DG-7D/YuinoCraneGame/SerialParallelPWM/README.md

# PWM出力シリアルパラレル変換器

UARTで受信したビット列の各ビットに対応するピンから予め設定されたデューティー比のPWM信号を出力します。通常のシリアルパラレル変換器と異なりクロックが不要かつPWM出力ができます。

## ピン配置

### シリアル端子 (左上)

左から
- RESET
- TX
- RX

### パラレル出力端子 (中央上)

左から0-7

### 5V入力端子 (右上)

左から
- 5V
- GND

### 電源入力端子 (左下)

左から
- GND
- VCC

## 使い方

1バイト(8bit)のデータを受信すると、それぞれのビットが出力に対応します。
