DG-7D/YuinoCraneGame/LV8548MC/README.md

# LV8548MC

LV8548MCを2つまとめただけの基板です。

## ピン配置

### 入力端子 (右上)

左から0-7

### 出力端子 (右)

下から7-0

### 電源入力端子 (左下)

左から
- GND
- VCC
