DG-7D/YuinoCraneGame/クレーンゲーム操作方法.pdf

# クレーンゲーム操作方法

部員へ
- ACアダプタをコンセントに接続すると自動で初期化され、ボタンが光ると準備OKです
- 不具合が起きたらACアダプタををさしなおしてみてください
- なくなりそうだったら景品の補充をお願いします
- ボタンが光っているとき操作できます
- スティックを動かすとプレイ開始できます
- ボタンをおすか、一定時間がたつとアームがつかみます
- カプセルは袋へ返却してください
- 景品はご自由にお持ち帰りください
