DG-7D/YuinoCraneGame/Joystick/PCB/ジョイスティック.kicad_pcb

## KiCad design Joystick/PCB/ジョイスティック.kicad_pcb (2025-11-23)

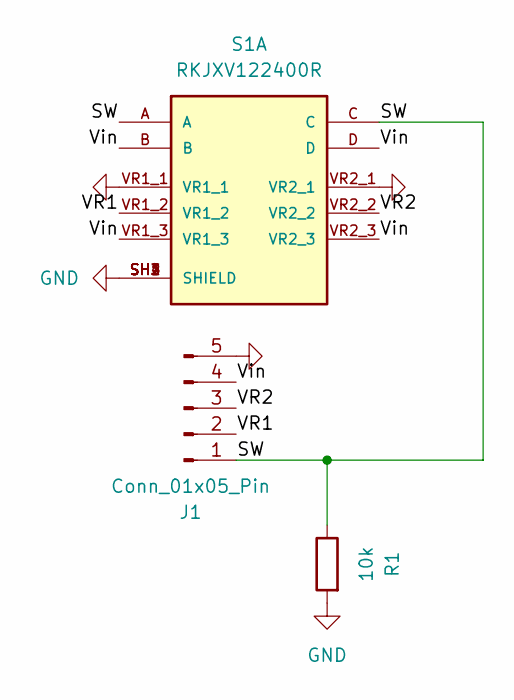
[picture p1: schematic ジョイスティック.kicad_sch]

Parts:
J1: Conn_01x05_Pin; PinHeader_1x05_P2.54mm_Horizontal
R1: 10k; R_0603_1608Metric
S1: RKJXV122400R; SW_RKJXV122400R; PARTREV N/A

Connections:
/SW: J1.1, R1.1, S1.A, S1.C
/VR1: J1.2, S1.VR1_2
/VR2: J1.3, S1.VR2_2
/Vin: J1.4, S1.B, S1.D, S1.VR1_3, S1.VR2_3
GND: J1.5, R1.2, S1.SH1 (SHIELD), S1.SH2 (SHIELD), S1.SH3 (SHIELD), S1.SH4 (SHIELD), S1.VR1_1, S1.VR2_1

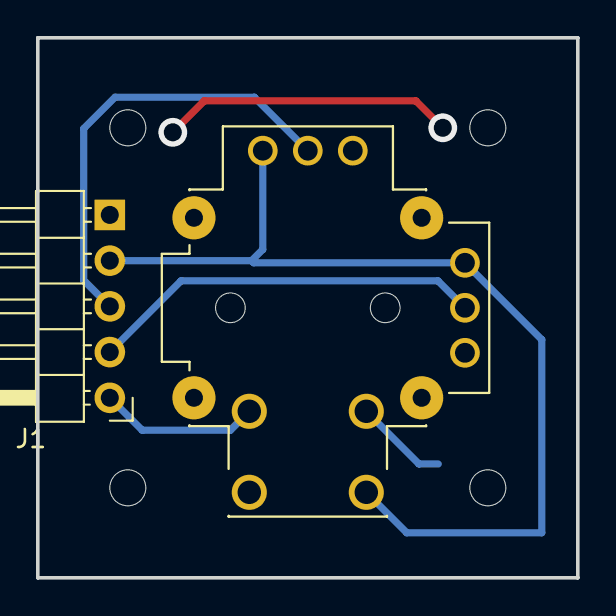
[picture p2: board ジョイスティック.kicad_pcb from above]

Board: 2 copper layers, 30.0 x 30.0 mm, 3 parts (1 on the bottom side), 5 nets.
