DG-7D/YuinoCraneGame/LV8548MC/PCB/LV8548MC.kicad_pcb

## KiCad design LV8548MC/PCB/LV8548MC.kicad_pcb (2025-04-22)

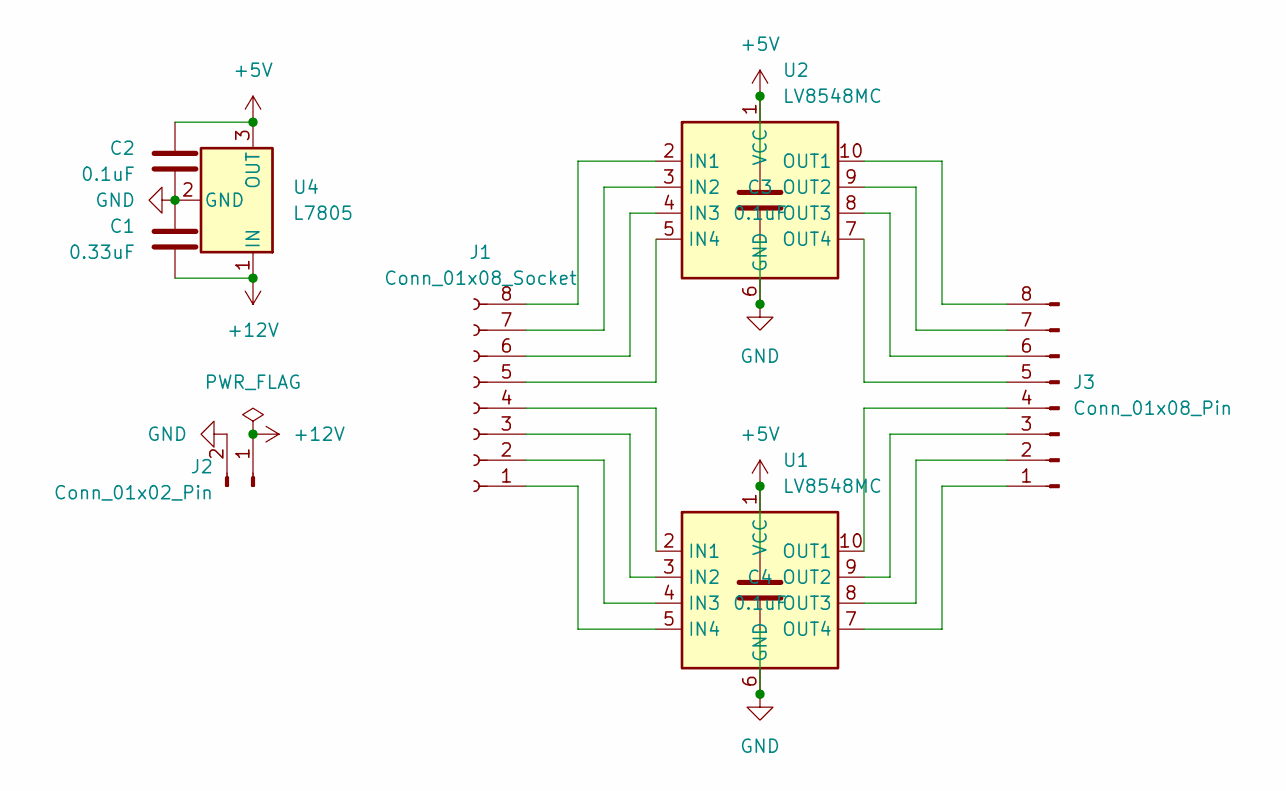
[picture p3: schematic LV8548MC.kicad_sch]

Parts:
C1: 0.33uF; C_0603_1608Metric_Pad1.08x0.95mm_HandSolder
C2, C3, C4: 0.1uF; C_0603_1608Metric_Pad1.08x0.95mm_HandSolder
J1: Conn_01x08_Socket; PinSocket_1x08_P2.54mm_Horizontal
J2: Conn_01x02_Pin; PinHeader_1x02_P2.54mm_Horizontal
J3: Conn_01x08_Pin; PinHeader_1x08_P2.54mm_Horizontal
U1, U2: LV8548MC; SOIC-10_3.9x4.9mm_P1mm
U4: L7805; TO-220-3_Horizontal_TabDown

Connections:
+5V: C2.1, C3.1, C4.1, U1.1 (VCC), U2.1 (VCC), U4.3 (OUT)
+12V: C1.1, J2.1, U4.1 (IN)
GND: C1.2, C2.2, C3.2, C4.2, J2.2, U1.6 (GND), U2.6 (GND), U4.2 (GND)
unnamed: J1.1, U1.5 (IN4)
unnamed: J1.2, U1.4 (IN3)
unnamed: J1.3, U1.3 (IN2)
unnamed: J1.4, U1.2 (IN1)
unnamed: J1.5, U2.5 (IN4)
unnamed: J1.6, U2.4 (IN3)
unnamed: J1.7, U2.3 (IN2)
unnamed: J1.8, U2.2 (IN1)
unnamed: J3.1, U1.7 (OUT4)
unnamed: J3.2, U1.8 (OUT3)
unnamed: J3.3, U1.9 (OUT2)
unnamed: J3.4, U1.10 (OUT1)
unnamed: J3.5, U2.7 (OUT4)
unnamed: J3.6, U2.8 (OUT3)
unnamed: J3.7, U2.9 (OUT2)
unnamed: J3.8, U2.10 (OUT1)

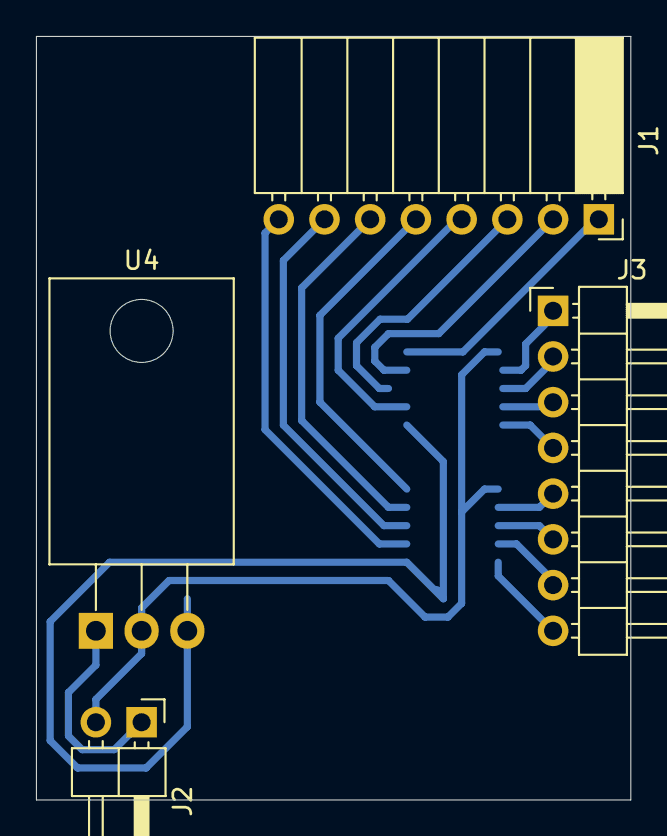
[picture p4: board LV8548MC.kicad_pcb from above]

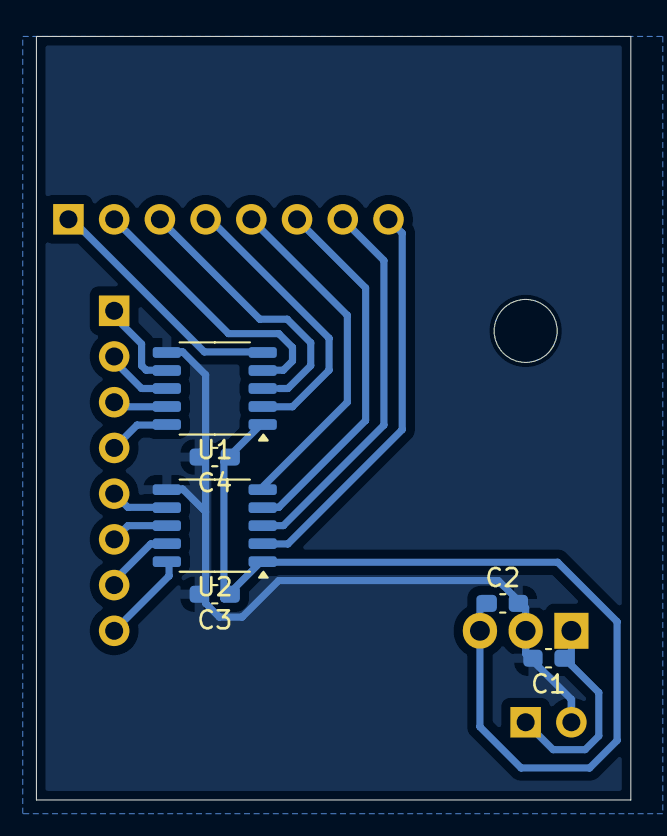
[picture p5: board LV8548MC.kicad_pcb from below]

Board: 2 copper layers, 33.0 x 42.4 mm, 10 parts (6 on the bottom side), 19 nets.
