DG-7D/YuinoCraneGame/SerialParallelPWM/ISCPAdapter/ISCPAdapter.kicad_pcb

## KiCad design SerialParallelPWM/ISCPAdapter/ISCPAdapter.kicad_pcb (2025-04-22)

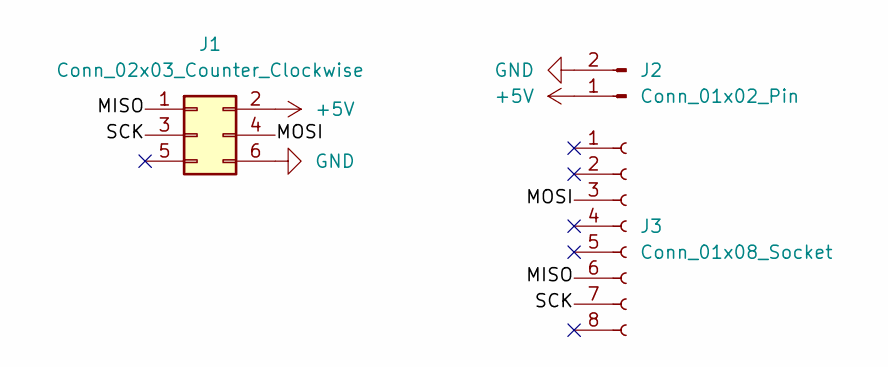
[picture p6: schematic ISCPAdapter.kicad_sch]

Parts:
J1: Conn_02x03_Counter_Clockwise; PinSocket_2x03_P2.54mm_Vertical
J2: Conn_01x02_Pin; PinHeader_1x02_P2.54mm_Horizontal
J3: Conn_01x08_Socket; PinSocket_1x08_P2.54mm_Horizontal

Connections:
+5V: J1.2, J2.1
/MISO: J1.1, J3.6
/MOSI: J1.4, J3.3
/SCK: J1.3, J3.7
GND: J1.6, J2.2

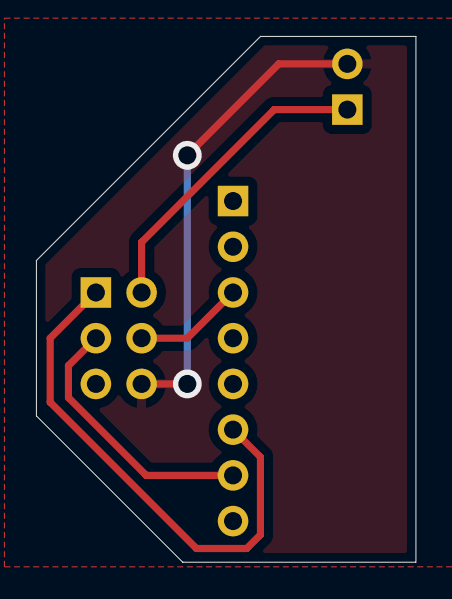
[picture p7: board ISCPAdapter.kicad_pcb from above]

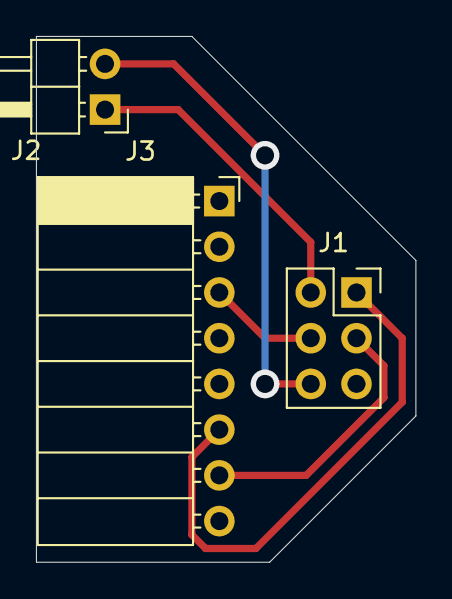
[picture p8: board ISCPAdapter.kicad_pcb from below]

Board: 2 copper layers, 21.1 x 29.2 mm, 3 parts (3 on the bottom side), 5 nets.
