DG-7D/YuinoCraneGame/SerialParallelPWM/PCB/SerialParallelPWM.kicad_pcb

## KiCad design SerialParallelPWM/PCB/SerialParallelPWM.kicad_pcb (2025-04-22)

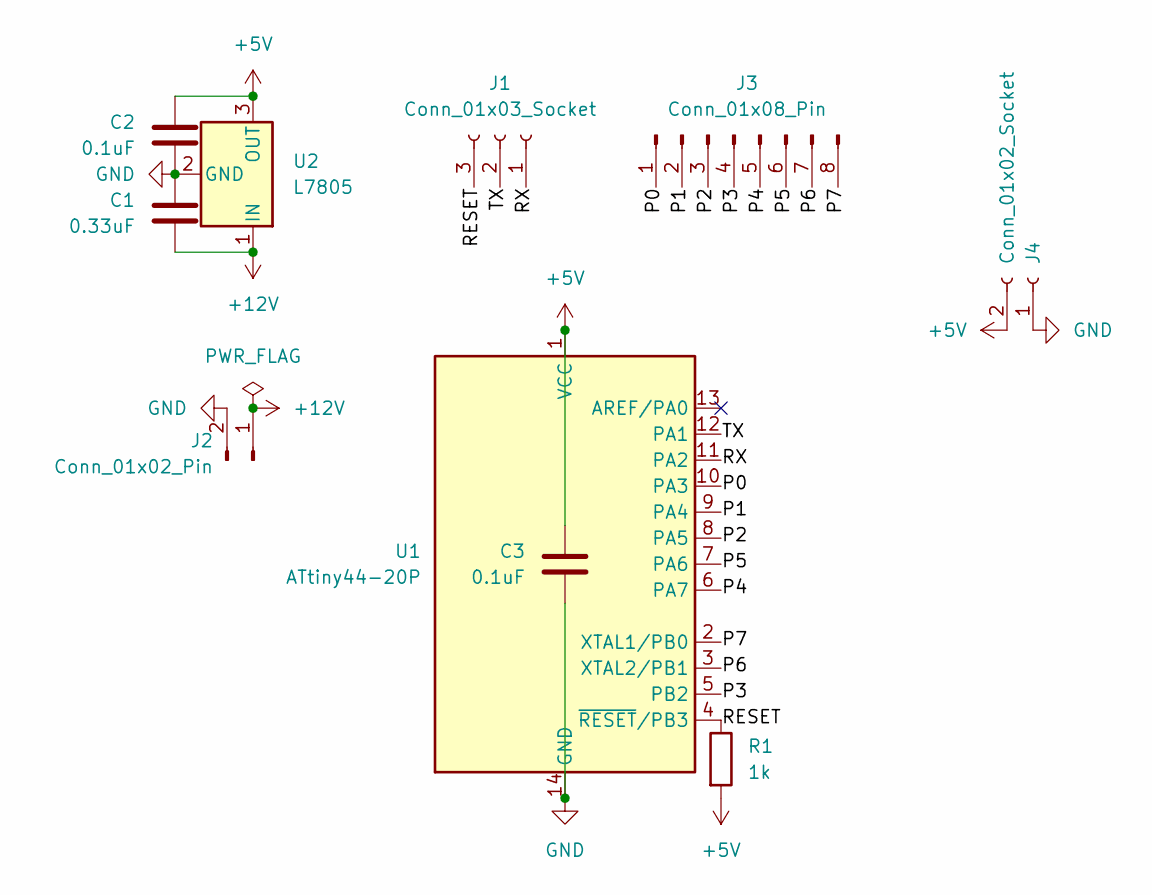
[picture p9: schematic SerialParallelPWM.kicad_sch]

Parts:
C1: 0.33uF; C_0603_1608Metric_Pad1.08x0.95mm_HandSolder
C2, C3: 0.1uF; C_0603_1608Metric_Pad1.08x0.95mm_HandSolder
J1: Conn_01x03_Socket; PinSocket_1x03_P2.54mm_Horizontal
J2: Conn_01x02_Pin; PinHeader_1x02_P2.54mm_Horizontal
J3: Conn_01x08_Pin; PinHeader_1x08_P2.54mm_Horizontal
J4: Conn_01x02_Socket; PinSocket_1x02_P2.54mm_Horizontal
R1: 1k; R_0603_1608Metric_Pad0.98x0.95mm_HandSolder
U1: ATtiny44-20P; DIP-14_W7.62mm_Socket
U2: L7805; TO-220-3_Horizontal_TabDown

Connections:
+5V: C2.1, C3.1, J4.2, R1.2, U1.1 (VCC), U2.3 (OUT)
+12V: C1.2, J2.1, U2.1 (IN)
/P0: J3.1, U1.10 (PA3)
/P1: J3.2, U1.9 (PA4)
/P2: J3.3, U1.8 (PA5)
/P3: J3.4, U1.5 (PB2)
/P4: J3.5, U1.6 (PA7)
/P5: J3.6, U1.7 (PA6)
/P6: J3.7, U1.3 (XTAL2/PB1)
/P7: J3.8, U1.2 (XTAL1/PB0)
/RESET: J1.3, R1.1, U1.4 (~RESET/PB3)
/RX: J1.1, U1.11 (PA2)
/TX: J1.2, U1.12 (PA1)
GND: C1.1, C2.2, C3.2, J2.2, J4.1, U1.14 (GND), U2.2 (GND)

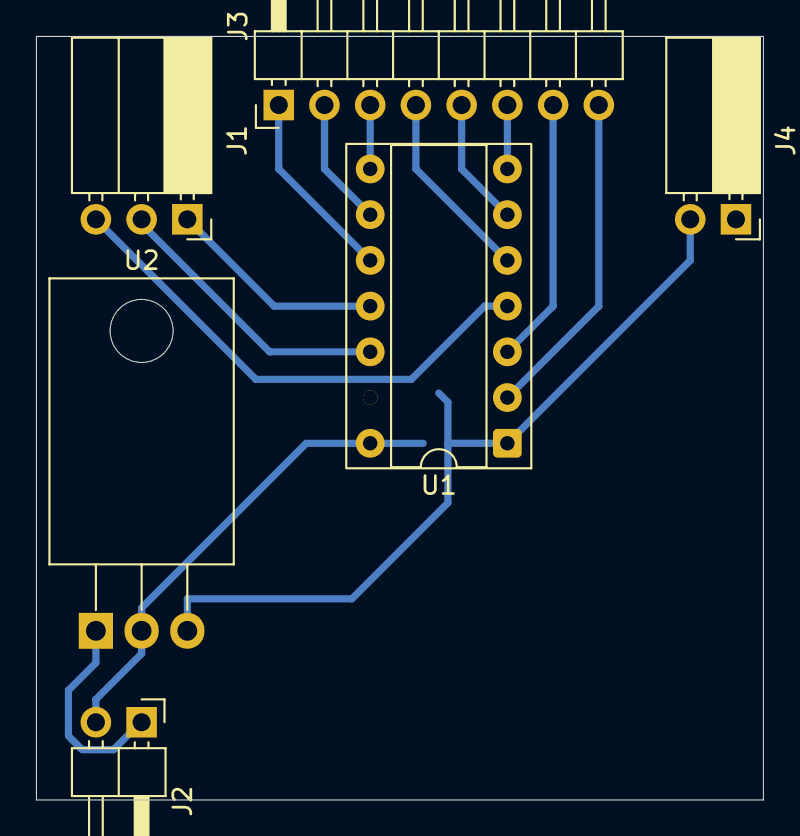
[picture p10: board SerialParallelPWM.kicad_pcb from above]

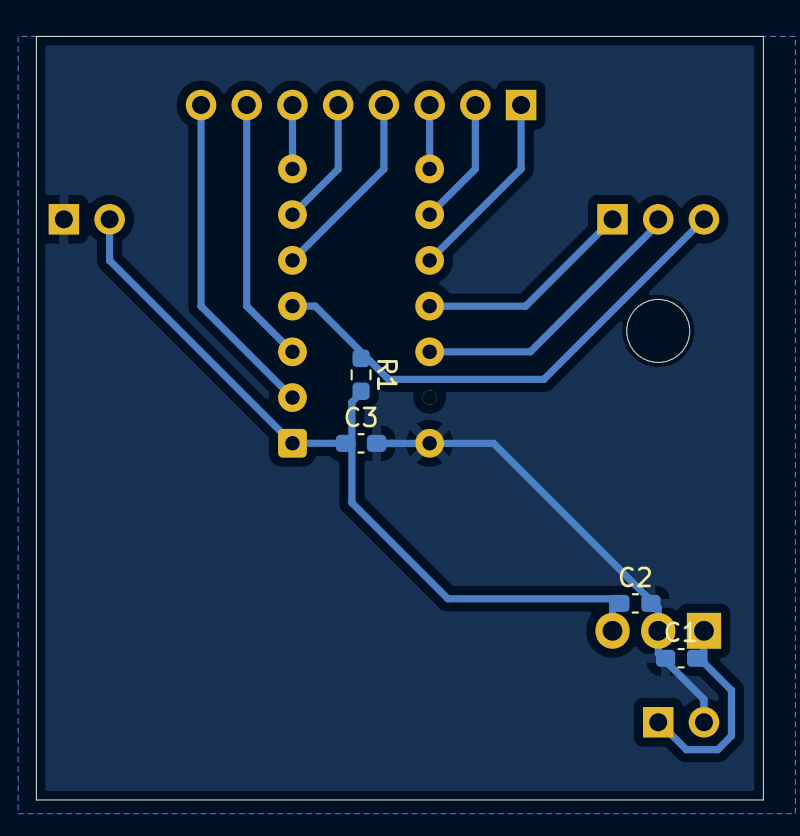
[picture p11: board SerialParallelPWM.kicad_pcb from below]

Board: 2 copper layers, 40.4 x 42.4 mm, 10 parts (4 on the bottom side), 14 nets.
