DG-7D/YuinoCraneGame/SerialParallelPWM/Test/README.md

# シリアルパラレル変換器テスト

シリアルパラレル変換器のテスト用のプログラムです。

## 使い方

シリアル接続して`1`から`8`までのキーを押下すると、対応するピンの出力が切り替わります。その他のキーを押下すると、全てのピンの出力がLOWになります。シリアルモニタは改行コード等が送信されない直接入力モード (pio device monitorでは既定) で使用してください。

## ピン配置

- 11: UART TX - ATtinyX4のRX (11) に接続
- 12: UART RX - ATtinyX4のTX (12) に接続
