DG-7D/YuinoCraneGame/(commit log)

2024-11-22 いにしゃるこみっと
2024-11-22 サーボピン要変更
2024-11-22 操作中出力を追加
2024-11-22 間違ったリミットスイッチを参照していたのを修正
2024-11-22 原点復帰でまっすぐ戻るようになったかもしれない
2024-11-22 Y軸の制御の処理を修正、不要な定数を削除
2024-11-23 ピン配置修正、ゼロ除算修正
2024-11-23 操作終了時に暴走するのを修正
2024-11-23 原点復帰しないのを修正
2024-11-23 原点復帰の挙動を単純に戻した
2024-11-23 ピン配置ドキュメント追加
2024-11-23 README修正
2024-11-23 最初の入力を待てていなかったのを修正
2024-11-23 delayを削除、信号の判定式を統一
2024-11-23 各動作のタイミングをいいかんじにした
2024-11-24 XY軸の個別設定に対応
2024-11-24 下げる時間と上げる時間を変えられるようにした
2024-11-24 確率を調整
2024-11-24 巻上時間調整
2024-11-24 Z軸の時間を調整
2024-11-24 Z軸リミットスイッチ対応
2024-11-24 Z軸巻上時指定時間であきらめるよう変更
2024-11-24 制御プログラムをサブディレクトリに移動
2025-03-21 L293DのCAD
    [L293D.kicad_pcb, L293D.kicad_sch]
2025-03-23 L293Dの基板をつくった
    [L293D.kicad_pcb, L293D.kicad_sch]
2025-03-23 L293D基板用ぷろぐらむ
2025-03-23 ビアをでかくした
    [L293D.kicad_pcb]
2025-03-23 PWMの周波数上げても耐えそう
2025-03-25 ピンによってパルス幅を変えられるようにした
2025-03-31 ATtiny44にした、内蔵クロックの設定をした
2025-03-31 シリアルしばくやつつくった
2025-04-01 設定追加したら動いた
2025-04-01 ATtinyが返事するようにした
2025-04-01 Revert "設定追加したら動いた"
    This reverts commit 6cbb29fd8f0ff04b36fe2659b9c5731ed7a8a2af.
2025-04-01 gitignoreを追加
2025-04-04 ブートローダを書き込めるようにした
2025-04-04 wip シールドを介してGNDがつながってる
    [ジョイスティック.kicad_pcb, ジョイスティック.kicad_sch]
2025-04-05 L293D基板を更新 出力に直列抵抗を追加 パスコンを追加 リセット入力を追加
    [L293D.kicad_pcb, L293D.kicad_sch]
2025-04-07 microsやめた
2025-04-07 uno破壊
2025-04-07 ピン出力もレジスタをしばくようにした
2025-04-07 ピン修正
2025-04-08 多分全部つながった
    [ジョイスティック.kicad_pcb]
2025-04-13 optiboot経由での書き込みに対応
2025-04-16 バカの配線を破壊
    [ジョイスティック.kicad_pcb, ジョイスティック.kicad_sch]
2025-04-19 もろもろの場所変更
    [L293D.kicad_pcb, L293D.kicad_sch]
2025-04-20 ヒューズビット修正
2025-04-22 とりあえず部品置いた
    [LV8548MC.kicad_pcb, LV8548MC.kicad_sch, SerialParallelPWM.kicad_pcb, SerialParallelPWM.kicad_sch]
2025-04-22 LV8548MC基板
    [LV8548MC.kicad_pcb, LV8548MC.kicad_sch]
2025-04-22 パラレル変換基板
    [SerialParallelPWM.kicad_pcb, SerialParallelPWM.kicad_sch]
2025-04-22 ISCPアダプタ
    [ISCPAdapter.kicad_pcb, ISCPAdapter.kicad_sch]
2025-05-16 ピン配置を新基板に合わせた
2025-11-20 ジョイスティックをセンターに配置
    [ジョイスティック.kicad_pcb, ジョイスティック.kicad_sch]
2025-11-20 joystick制御 v1
2025-11-20 一応動く ピンの修正とかバグの修正とか
2025-11-20 ESP32Servoライブラリの追加
2025-11-20 モータ速度変更
2025-11-22 WIP 遊星ギヤ対応版
2025-11-22 純正版platformを明示
2025-11-22 ジョイスティック: プルアップに変更
2025-11-22 ジョイスティック: いろいろ
2025-11-22 パラメータ調整
2025-11-22 もろもろ修正
2025-11-23 古いものを削除
    [L293D.kicad_pcb, L293D.kicad_sch]
2025-12-03 掲示用PDF
